msx-solis/O4MEGA/omega-ramexpansion_iron/omega-ramexpansion.jpg

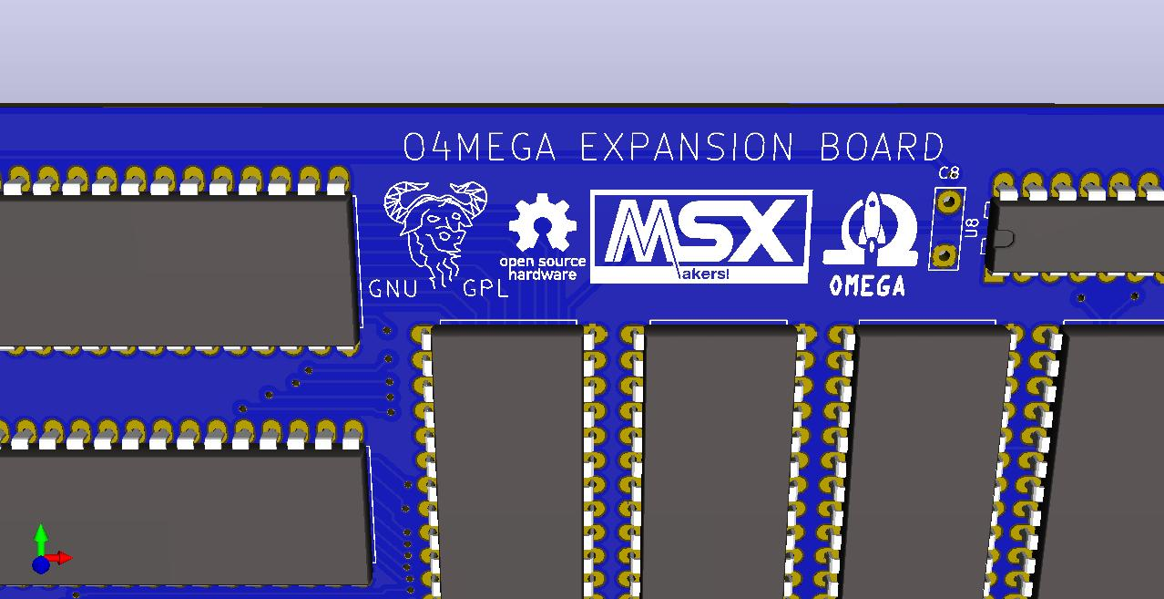
omega-ramexpansion_iron/omega-ramexpansion.jpg
