msx-solis/O4MEGA/omega-ramexpansion_iron/omega-ramexpansion.png

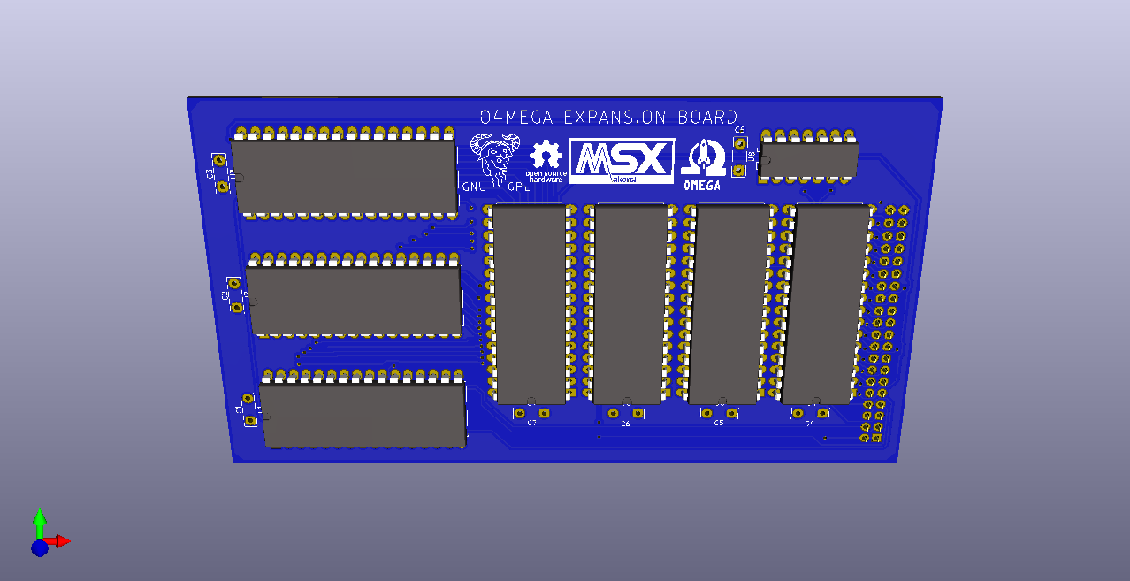
omega-ramexpansion_iron/omega-ramexpansion.png
