msx-solis/O4MEGA/README.md

# o4Mega v1.
4Mb expansion for OMEGA MSX2+ HOME COMPUTER.
Here is my first board design to expand OMEGA Home Computer from 1Mb to 4Mb of static RAM.
This design is optimized to manufacture the pcb with the toner transfer technique.
