msx-solis/O4MEGA/omega-ramexpansion_iron/omega-ramexpansion.pdf

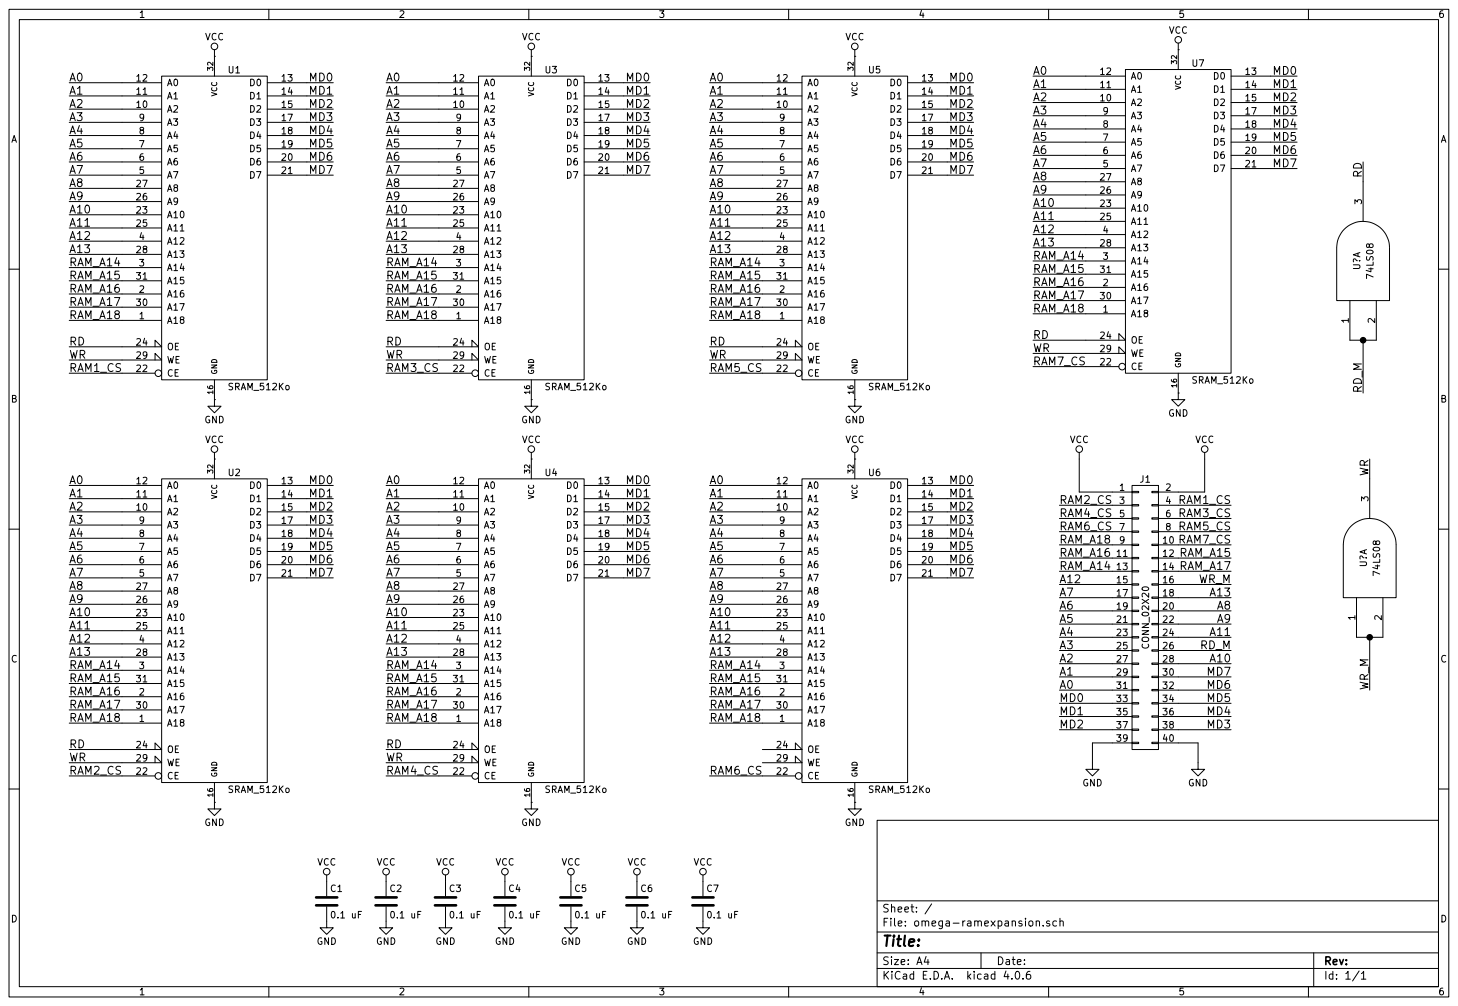
[picture p3: page 1]

File: omega-ramexpansion.sch Sheet: /
