msx-solis/O4MEGA/omega-ramexpansion_iron/Gerber/omega-ramexpansion-B_Cu.pdf

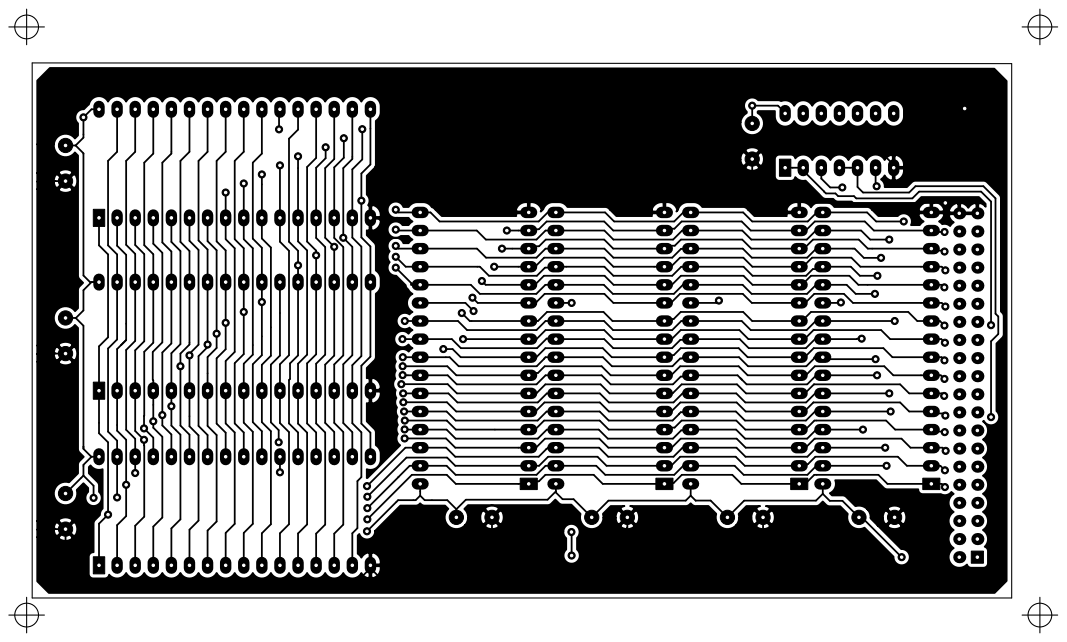
[picture p4: page 1]
