msx-solis/O4MEGA/omega-ramexpansion_iron/Gerber/omega-ramexpansion-B_Mask.pdf

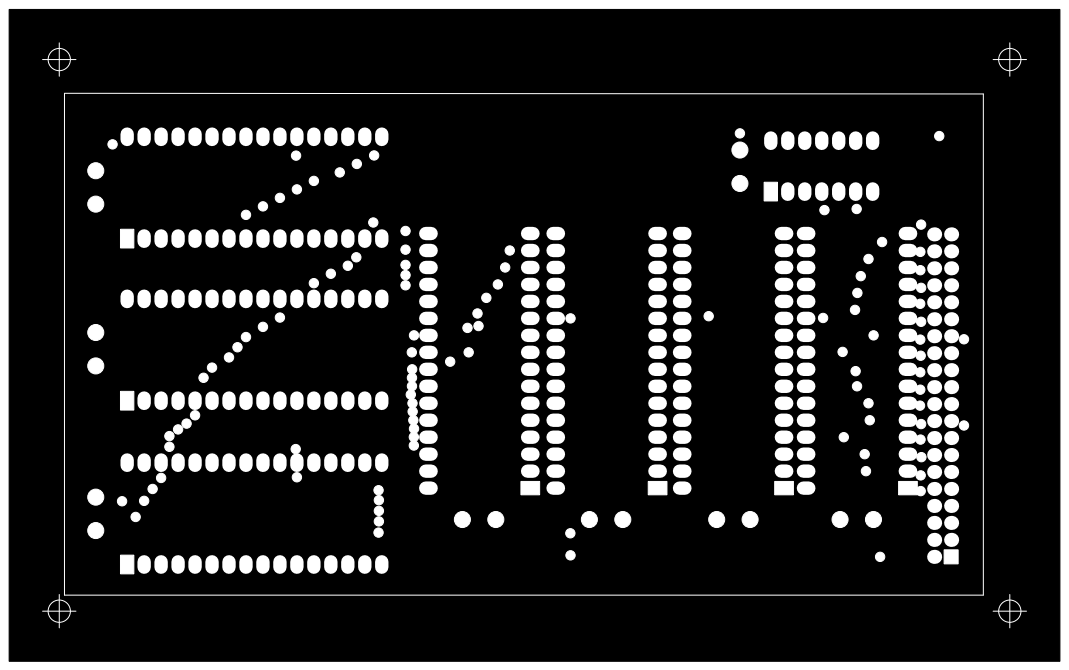
[picture p5: page 1]
