msx-solis/O4MEGA/omega-ramexpansion_iron/Gerber/omega-ramexpansion-F_Cu.pdf

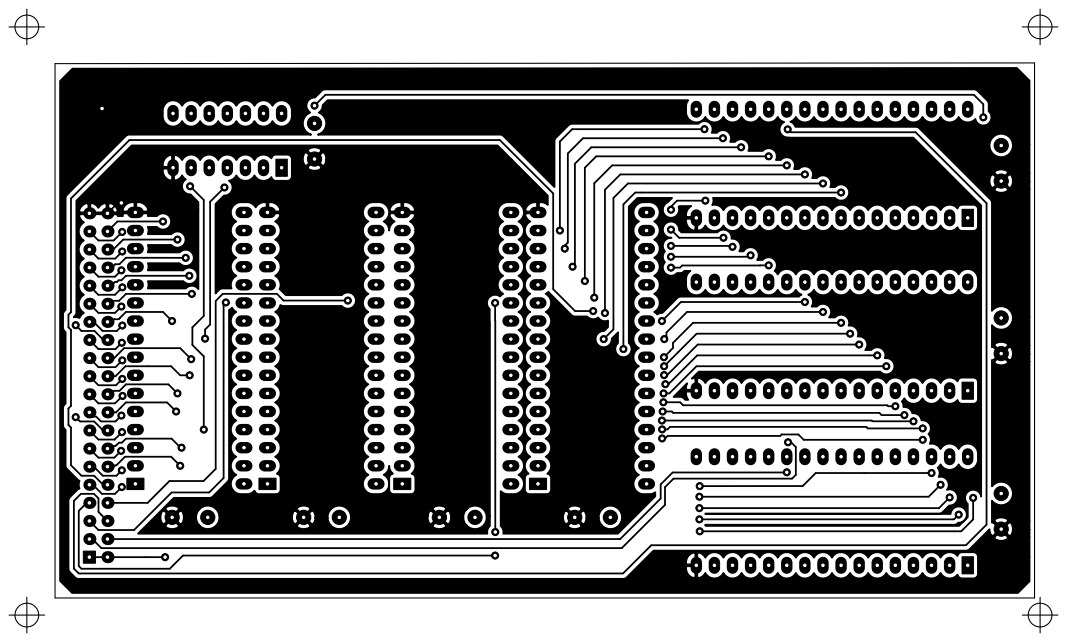
[picture p6: page 1]
