msx-solis/O4MEGA/omega-ramexpansion_iron/Gerber/omega-ramexpansion-F_Mask.pdf

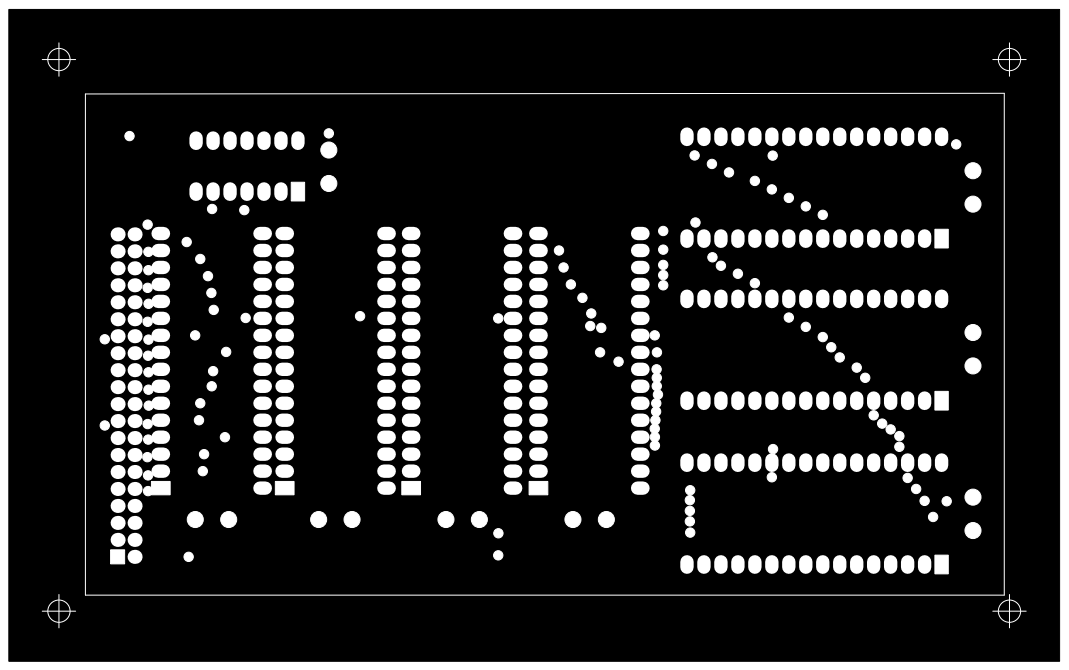
[picture p7: page 1]
