msx-solis/O4MEGA/omega-ramexpansion_iron/Gerber/omega-ramexpansion-F_SilkS.pdf

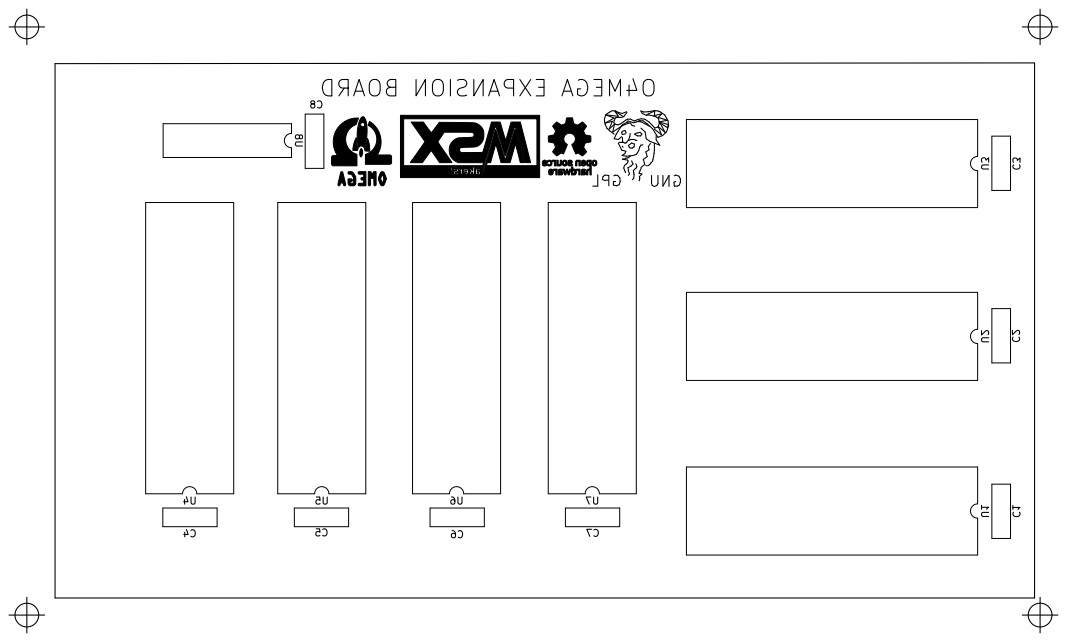
[picture p8: page 1]
